wizwoz01/A2ZYNQ/docs/images/cardtest.png

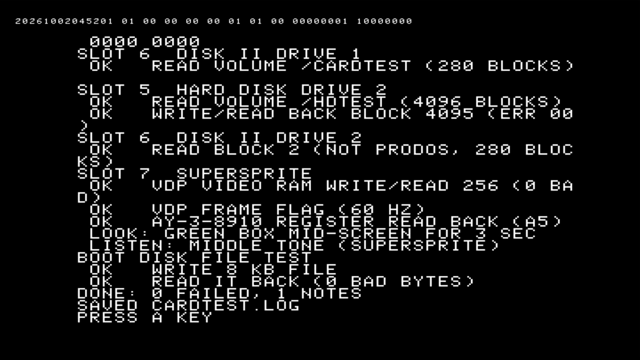
docs/images/cardtest.png
