wizwoz01/A2ZYNQ/hardware/pcb/bottom.png

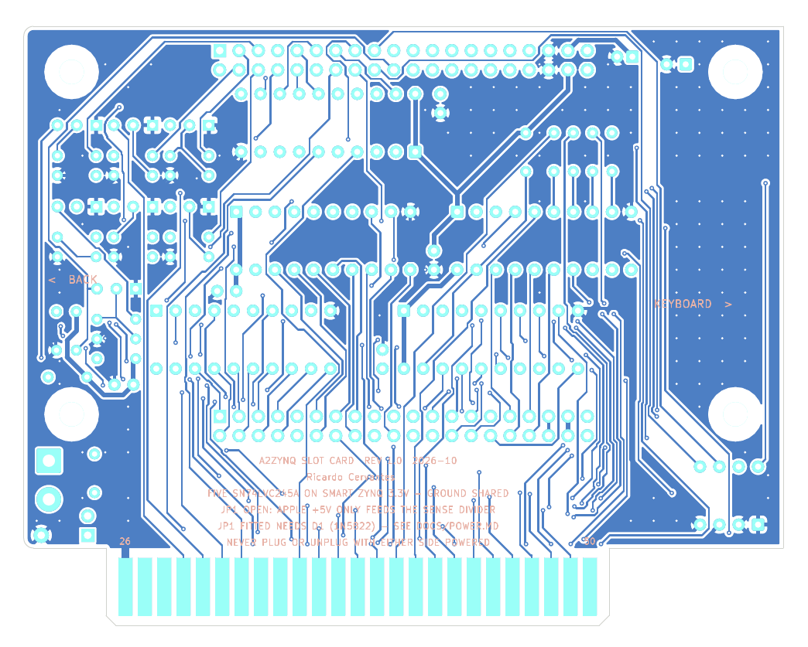
hardware/pcb/bottom.png
