wizwoz01/A2ZYNQ/hardware/schematics/red_proto_card_schematic.pdf

A | A
B | B
C | C
D | D

### A2N20v2 Red Proto Card

Block Diagram

Size: A4 | Rev: 3.0 | 1/13

from Smart Zynq style

# Red Proto Card — System Block Diagram

Apple II Slot

JAPPLE 50-pin
5V bus logic
CARD_5V / GND

Proto Card

U1–U4 SN74LVC245A
U5 TXB0108/TXS0108
Q1–Q6 OC drivers
Q7 /RES sense

Smart Zynq

JZ1 = U12 Bank33
JZ2 = U13 Bank35
VCC3V3 out
Apple nets | A2_* nets

POWER DOMAINS
CARD_5V = Apple pin 25 → U5 VCCB + 15k/22k sense only
VCC3V3 = Zynq JZ1/JZ2 pins 37–38 → U1–U4 VCC, U5 VCCA, pull-ups, Q7 pull-up GND = Apple pin 26 ↔ JGND (≥4 wires) ↔ Zynq GND
JZ 39–40 board +5V = DEFAULT NOT CONNECTED

SHEETS
2–5 U1–U4 6 U5 TXB 7–8 Q1–Q6 9 Q7+5V sense 10 JAPPLE 11 JZ1/U12 12 JZ2/U13 13 Rules / short check

# A2N20v2 / Smart Zynq Proto Adapter

# U1 SN74LVC245A

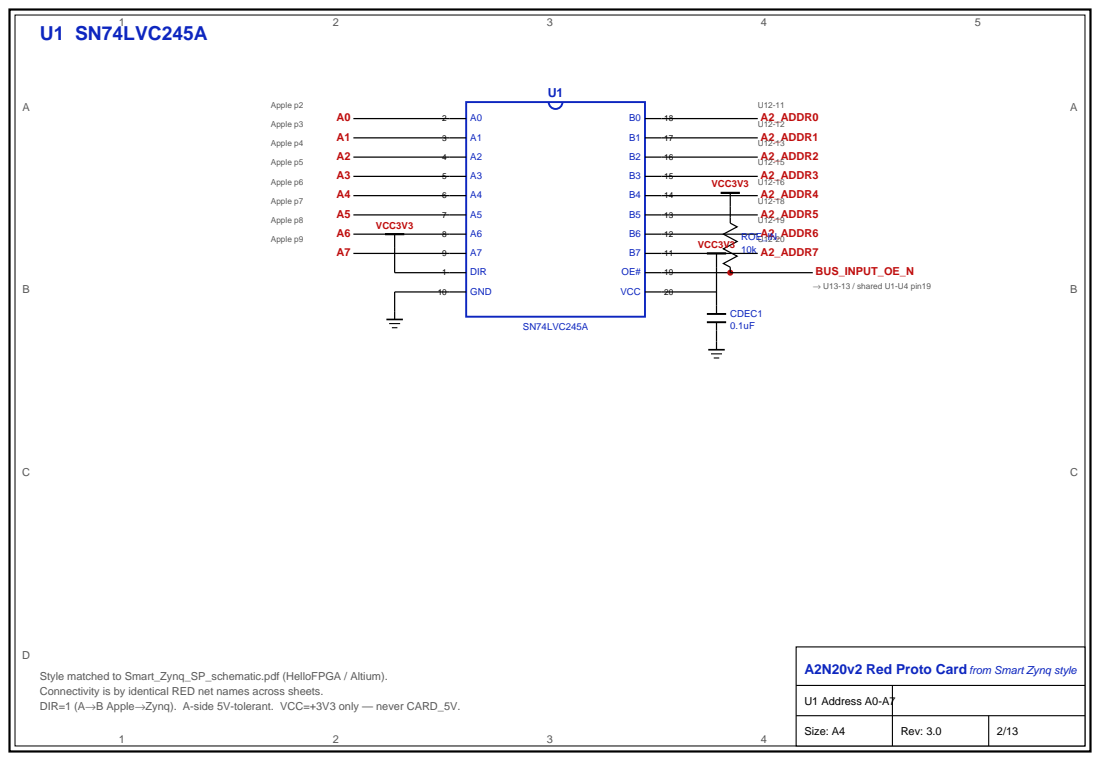
[picture p6: page 2]
U1 Address A0-A7; SN74LVC245A; DIR; GND; VCC; Apple p2; Apple p3; Apple p4; Apple p5; Apple p6; Apple p7; Apple p8; Apple p9; A2_ADDR0; A2_ADDR1; A2_ADDR2; A2_ADDR3; A2_ADDR4; A2_ADDR5; A2_ADDR6; A2_ADDR7; VCC3V3; ROE_IN 10k; BUS_INPUT_OE_N; → U13-13 / shared U1-U4 pin19; CDEC1 0.1uF

Style matched to Smart_Zynq_SP_schematic.pdf (HelloFPGA / Altium).
Connectivity is by identical RED net names across sheets.
DIR=1 (A→B Apple→Zynq). A-side 5V-tolerant. VCC=+3V3 only — never CARD_5V.

A2N20v2 Red Proto Card

from Smart Zynq style

# U2 SN74LVC245A

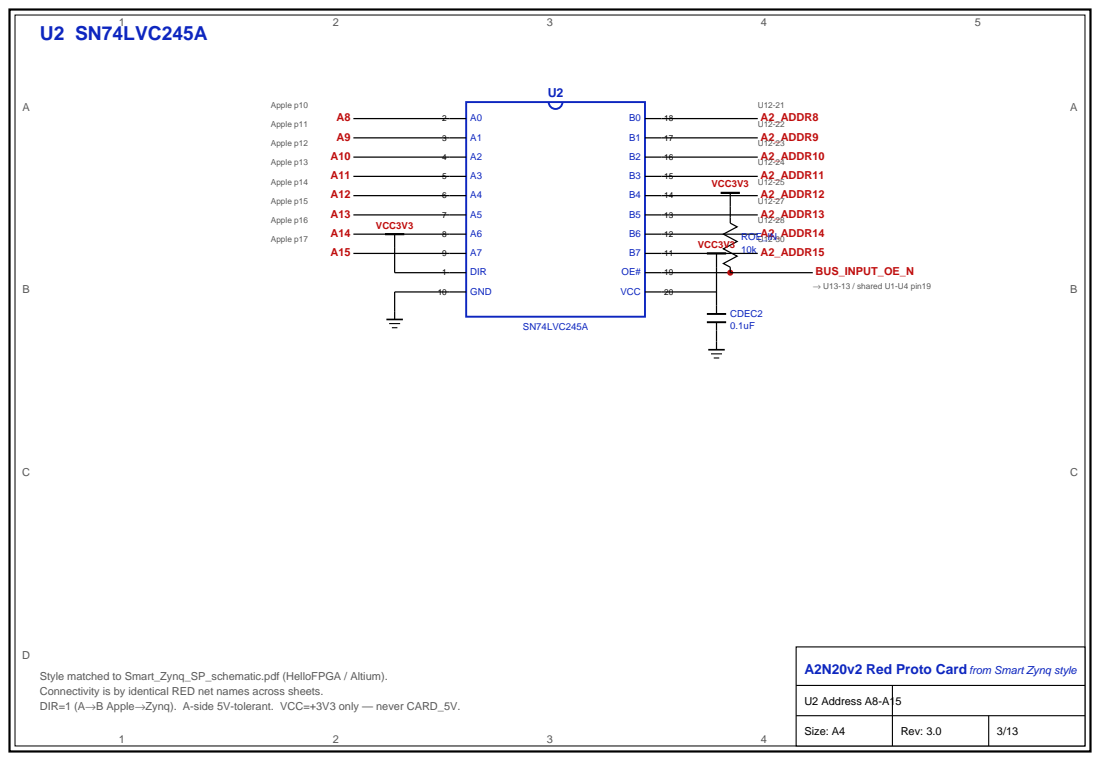
[picture p7: page 3]
U2 Address A8-A15; SN74LVC245A; DIR; GND; VCC; Apple p10; Apple p11; Apple p12; Apple p13; Apple p14; Apple p15; Apple p16; Apple p17; A2_ADDR8; A2_ADDR9; A2_ADDR10; A2_ADDR11; A2_ADDR12; A2_ADDR13; A2_ADDR14; A2_ADDR15; VCC3V3; ROE_IN 10k; BUS_INPUT_OE_N; → U13-13 / shared U1-U4 pin19; CDEC2 0.1uF

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

A2N20v2 Red Proto Card

from Smart Zynq style

# U3 SN74LVC245A

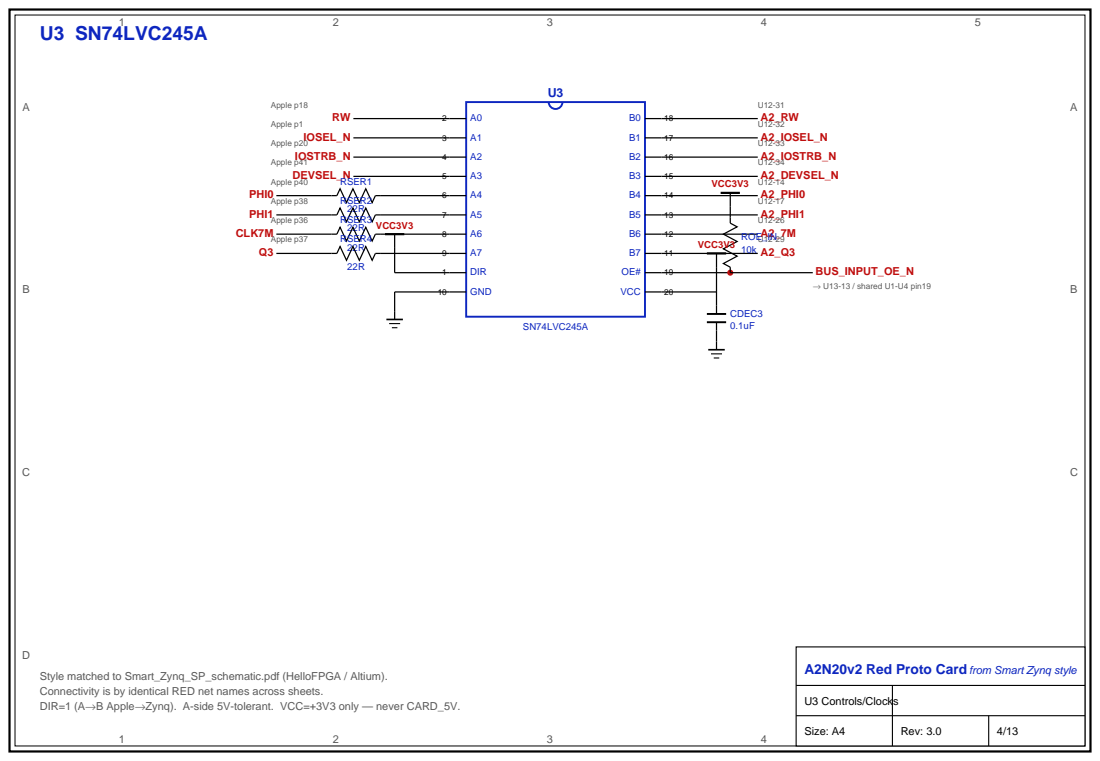
[picture p8: page 4]
U3 Controls/Clocks; SN74LVC245A; DIR; GND; VCC; Apple p18; IOSEL_N; Apple p1; IOSTRB_N; Apple p20; DEVSEL_N; Apple p41; RSER1; PHI0; Apple p40; RSER2; PHI1; Apple p38; RSER3; CLK7M; Apple p36; RSER4; Apple p37; A2_IOSEL_N; A2_IOSTRB_N; A2_DEVSEL_N; A2_PHI0; A2_PHI1; VCC3V3; ROE_IN 10k; BUS_INPUT_OE_N; → U13-13 / shared U1-U4 pin19; CDEC3 0.1uF

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

A2N20v2 Red Proto Card

from Smart Zynq style

# U4 SN74LVC245A

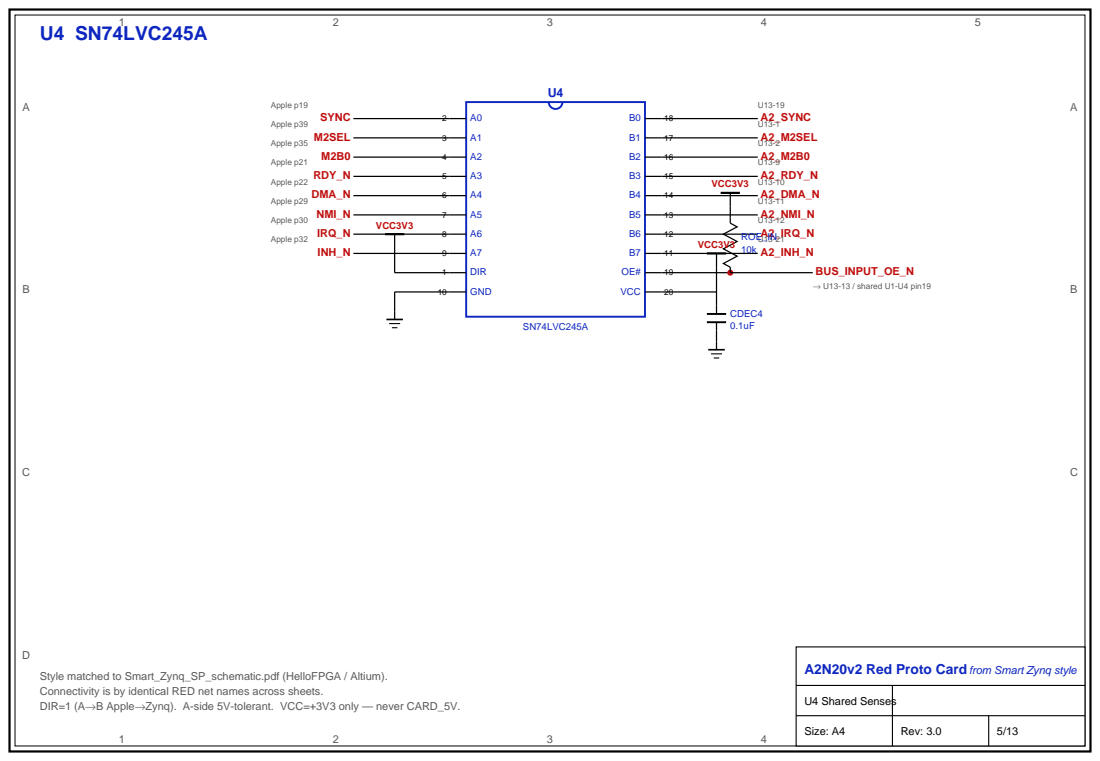
[picture p9: page 5]
U4 Shared Senses; SN74LVC245A; DIR; GND; VCC; SYNC; Apple p19; M2SEL; Apple p39; Apple p35; RDY_N; Apple p21; DMA_N; Apple p22; NMI_N; Apple p29; IRQ_N; Apple p30; INH_N; Apple p32; A2_SYNC; A2_M2SEL; A2_RDY_N; A2_DMA_N; A2_NMI_N; A2_IRQ_N; A2_INH_N; VCC3V3; ROE_IN 10k; BUS_INPUT_OE_N; → U13-13 / shared U1-U4 pin19; CDEC4 0.1uF

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

A2N20v2 Red Proto Card

from Smart Zynq style

# U5 TXB0108 / TXS0108 — D0–D7

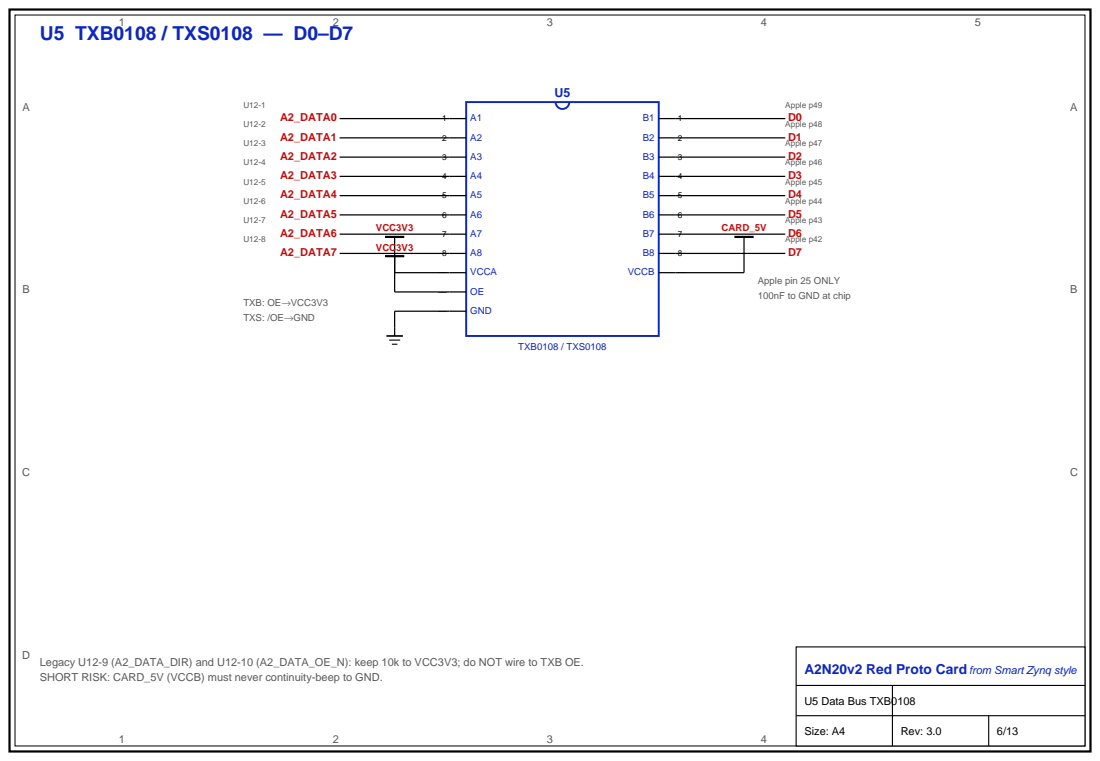
[picture p10: page 6]

Apple pin 25 ONLY
100nF to GND at chip

Legacy U12-9 (A2_DATA_DIR) and U12-10 (A2_DATA_OE_N): keep 10k to VCC3V3; do NOT wire to TXB OE.
SHORT RISK: CARD_5V (VCCB) must never continuity-beep to GND.

from Smart Zynq style

# Q1–Q3 Open Collector

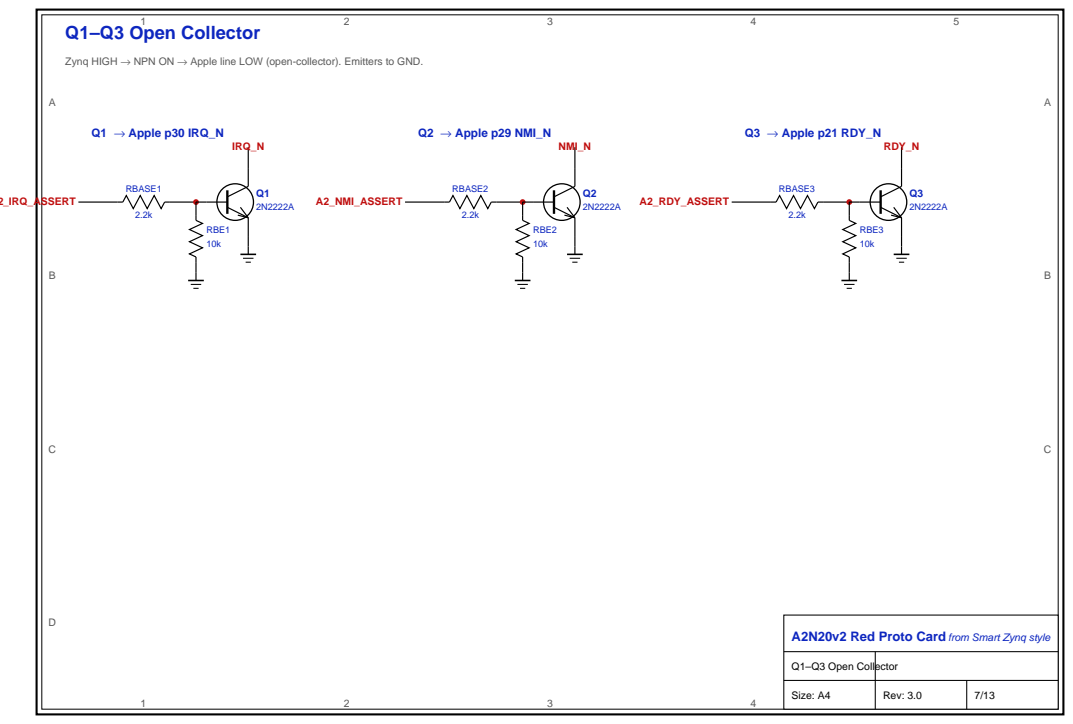
[picture p11: page 7]
Q1–Q3 Open Collector; Q1 → Apple p30 IRQ_N; A2_IRQ_ASSERT; RBASE1; RBE1 10k; IRQ_N; Q2 → Apple p29 NMI_N; A2_NMI_ASSERT; RBASE2; RBE2 10k; NMI_N; Q3 → Apple p21 RDY_N; A2_RDY_ASSERT; RBASE3; RBE3 10k; RDY_N

Zynq HIGH → NPN ON → Apple line LOW (open-collector). Emitters to GND.

A2N20v2 Red Proto Card

from Smart Zynq style

# Q4–Q6 Open Collector

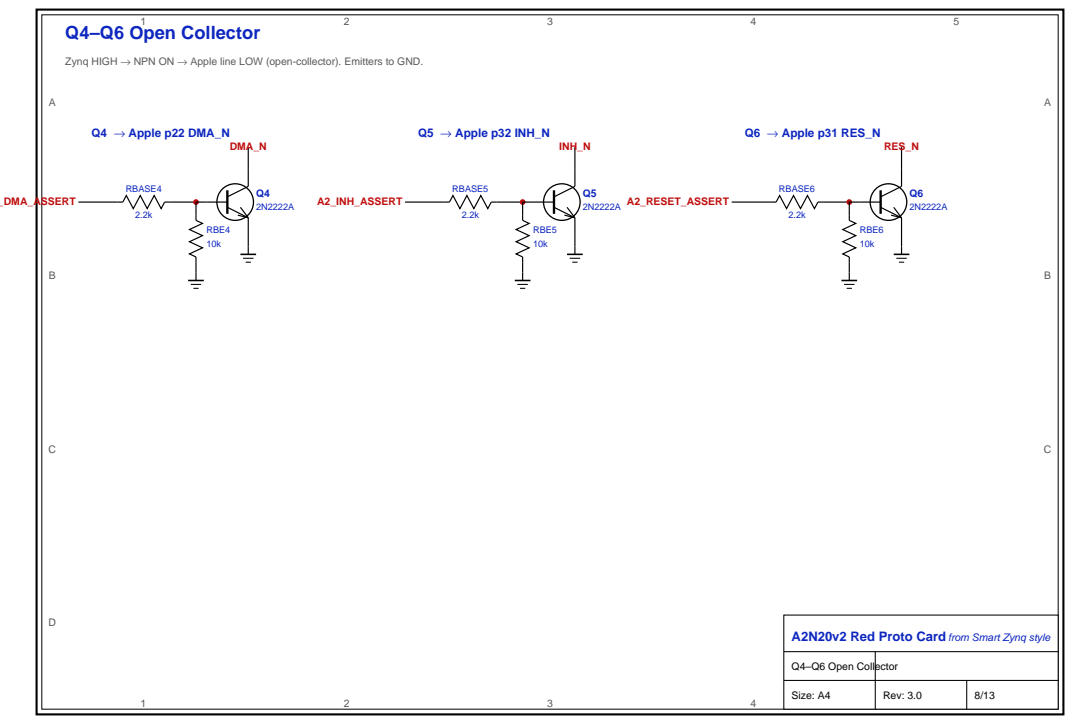
[picture p12: page 8]
Q4–Q6 Open Collector; Q4 → Apple p22 DMA_N; A2_DMA_ASSERT; RBASE4; RBE4 10k; DMA_N; Q5 → Apple p32 INH_N; A2_INH_ASSERT; RBASE5; RBE5 10k; INH_N; Q6 → Apple p31 RES_N; A2_RESET_ASSERT; RBASE6; RBE6 10k; RES_N

Zynq HIGH → NPN ON → Apple line LOW (open-collector). Emitters to GND.

A2N20v2 Red Proto Card

from Smart Zynq style

# Q7 /RES sense (inverting)

# Apple +5V presence sense

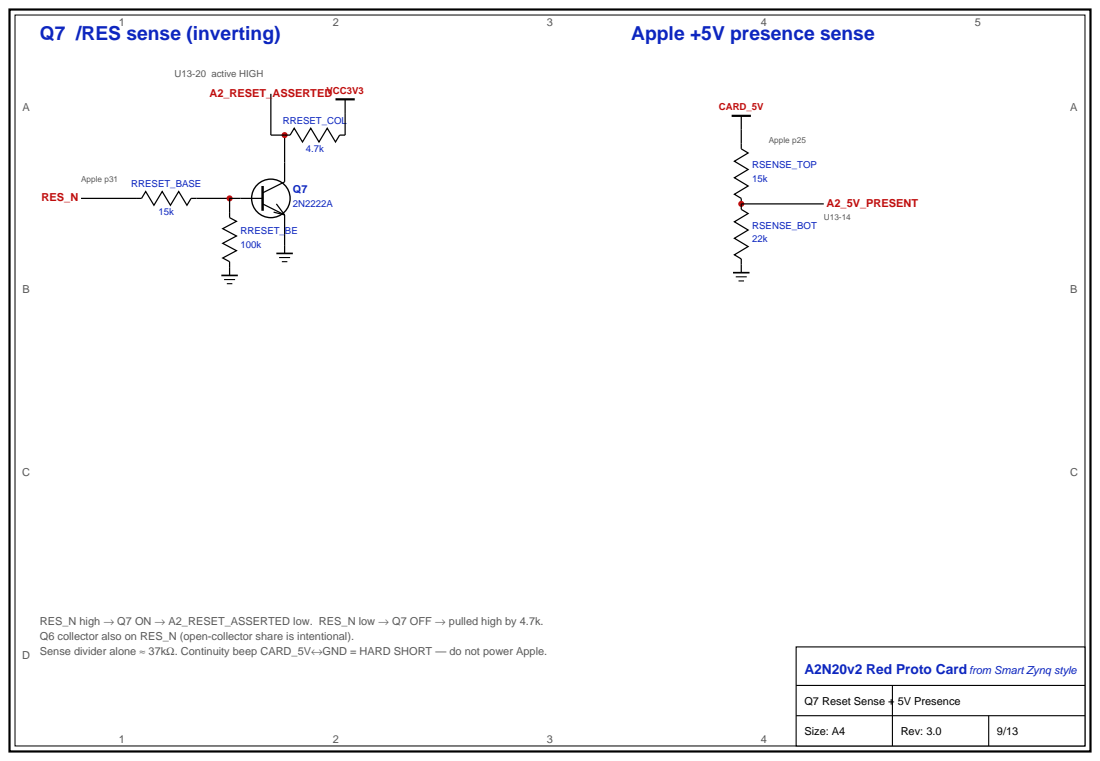
[picture p13: page 9]
RES_N; Apple p31; RRESET_BASE; RRESET_BE 100k; RRESET_COL; A2_RESET_ASSERTEDVCC3V3; U13-20 active HIGH; CARD_5V; Apple p25; RSENSE_TOP 15k; A2_5V_PRESENT; RSENSE_BOT 22k

RES_N high → Q7 ON → A2_RESET_ASSERTED low. RES_N low → Q7 OFF → pulled high by 4.7k.
Q6 collector also on RES_N (open-collector share is intentional).
Sense divider alone ≈ 37kΩ. Continuity beep CARD_5V↔GND = HARD SHORT — do not power Apple.

A2N20v2 Red Proto Card

from Smart Zynq style

Q7 Reset Sense + 5V Presence

A | A
B | B
C | C
D | D

### A2N20v2 Red Proto Card

JAPPLE

| from Smart Zynq style

# JAPPLE Apple II Edge JAPPLE

IOSEL_N | 1 | IOSEL_N
A0 | 2 | A0
A1 | 3 | A1
A2 | 4 | A2
A3 | 5 | A3
A4 | 6 | A4
A5 | 7 | A5
A6 | 8 | A6
A7 | 9 | A7
A8 | 10 | A8
A9 | 11 | A9
A10 | 12 | A10
A11 | 13 | A11
A12 | 14 | A12
A13 | 15 | A13
A14 | 16 | A14
A15 | 17 | A15
RW | 18 | RW
SYNC | 19 | SYNC
IOSTRB_N | 20 | IOSTRB_N
RDY_N | 21 | RDY_N
DMA_N | 22 | DMA_N
23 | NC
24 | NC
| 25

CARD_5V

CARD_5V

JAPPLE

GND | 26
27 | NC
28 | NC
NMI_N | 29 | NMI_N
IRQ_N | 30 | IRQ_N
RES_N | 31 | RES_N
INH_N | 32 | INH_N
33 | NC
34 | NC
M2B0 | 35 | M2B0
CLK7M | 36 | CLK7M
Q3 | 37 | Q3
PHI1 | 38 | PHI1
M2SEL | 39 | M2SEL
PHI0 | 40 | PHI0
DEVSEL_N | 41 | DEVSEL_N
D7 | 42 | D7
D6 | 43 | D6
D5 | 44 | D5
D4 | 45 | D4
D3 | 46 | D3
D2 | 47 | D2
D1 | 48 | D1
D0 | 49 | D0
50 | NC

A | A
B | B
C | C
D | D

### A2N20v2 Red Proto Card

JZ1 U12

| from Smart Zynq style

# JZ1 U12/J6

JZ1

A2_DATA0 | 1 | A2_DATA0
A2_DATA1 | 2 | A2_DATA1
A2_DATA2 | 3 | A2_DATA2
A2_DATA3 | 4 | A2_DATA3
A2_DATA4 | 5 | A2_DATA4
A2_DATA5 | 6 | A2_DATA5
A2_DATA6 | 7 | A2_DATA6
A2_DATA7 | 8 | A2_DATA7
A2_DATA_DIR | 9 | A2_DATA_DIR
A2_DATA_OE_N | 10 | A2_DATA_OE_N
A2_ADDR0 | 11 | A2_ADDR0
A2_ADDR1 | 12 | A2_ADDR1
A2_ADDR2 | 13 | A2_ADDR2
A2_PHI0 | 14 | A2_PHI0
A2_ADDR3 | 15 | A2_ADDR3
A2_ADDR4 | 16 | A2_ADDR4
A2_PHI1 | 17 | A2_PHI1
A2_ADDR5 | 18 | A2_ADDR5
A2_ADDR6 | 19 | A2_ADDR6

JZ1

A2_ADDR7 | 20 | A2_ADDR7
A2_ADDR8 | 21 | A2_ADDR8
A2_ADDR9 | 22 | A2_ADDR9
A2_ADDR10 | 23 | A2_ADDR10
A2_ADDR11 | 24 | A2_ADDR11
A2_ADDR12 | 25 | A2_ADDR12
A2_7M | 26 | A2_7M
A2_ADDR13 | 27 | A2_ADDR13
A2_ADDR14 | 28 | A2_ADDR14
A2_Q3 | 29 | A2_Q3
A2_ADDR15 | 30 | A2_ADDR15
A2_RW | 31 | A2_RW
A2_IOSEL_N | 32 | A2_IOSEL_N
A2_IOSTRB_N | 33 | A2_IOSTRB_N
A2_DEVSEL_N | 34 | A2_DEVSEL_N
VCC3V3 | 37 | VCC3V3
VCC3V3 | 38 | VCC3V3
39 | NC
40 | NC
P 1 A2_DATA0 | U5-A1
P 2 A2_DATA1 | U5-A2
P 3 A2_DATA2 | U5-A3
P 4 A2_DATA3 | U5-A4
P 5 A2_DATA4 | U5-A5
P 6 A2_DATA5 | U5-A6
P 7 A2_DATA6 | U5-A7
P 8 A2_DATA7 | U5-A8

A | A
B | B
C | C
D | D

### A2N20v2 Red Proto Card

JZ2 U13

| from Smart Zynq style

# JZ2 U13/J5

JZ2

A2_M2SEL | 1 | A2_M2SEL
A2_M2B0 | 2 | A2_M2B0
A2_IRQ_ASSERT | 3 | A2_IRQ_ASSERT
A2_NMI_ASSERT | 4 | A2_NMI_ASSERT
A2_RDY_ASSERT | 5 | A2_RDY_ASSERT
A2_DMA_ASSERT | 6 | A2_DMA_ASSERT
A2_INH_ASSERT | 7 | A2_INH_ASSERT
A2_RESET_ASSERT | 8 | A2_RESET_ASSERT
A2_RDY_N | 9 | A2_RDY_N
A2_DMA_N | 10 | A2_DMA_N
A2_NMI_N | 11 | A2_NMI_N
A2_IRQ_N | 12 | A2_IRQ_N
BUS_INPUT_OE_N | 13 | BUS_INPUT_OE_N

JZ2

A2_5V_PRESENT | 14 | A2_5V_PRESENT
SW1 | 15 | SW1
SW2 | 16 | SW2
SW3 | 17 | SW3
SW4 | 18 | SW4
A2_SYNC | 19 | A2_SYNC
A2_RESET_ASSERTED | 20 | A2_RESET_ASSERTED
A2_INH_N | 21 | A2_INH_N
PL_READY | 27 | PL_READY
VCC3V3 | 37 | VCC3V3
VCC3V3 | 38 | VCC3V3
39 | NC
40 | NC
P 1 A2_M2SEL | U4-B1
P 2 A2_M2B0 | U4-B2
P 3 A2_IRQ_ASSERT | Q1
P 4 A2_NMI_ASSERT | Q2
P 5 A2_RDY_ASSERT | Q3
P 6 A2_DMA_ASSERT | Q4
P 7 A2_INH_ASSERT | Q5
P 8 A2_RESET_ASSERT | Q6

A | A
B | B
C | C
D | D

### A2N20v2 Red Proto Card

Rules / Short Checklist

| from Smart Zynq style

# Assembly rules & 5V short checklist

REQUIRED PARTS (manual BOM — often missed on first build)
ROE_IN 10k on BUS_INPUT_OE_N; ROE_DATA 10k on U12-10; RDIR_DATA 10k on U12-9 RSENSE_BOT 22k; CDEC 0.1uF on each LVC245; 0.1uF on TXB VCCA and VCCB

NC APPLE PINS: 23, 24, 27, 28, 33, 34, 50
JZ1/JZ2 pins 39–40 (+5V board) DEFAULT NC

TXB0108 OE = active HIGH → VCC3V3 TXS0108 /OE = active LOW → GND

5V ↔ GND SHORT (power OFF)
1. Card alone, ribbons off: meter Apple finger 25 to 26 — must NOT beep
2. If beep: bridge 25/26, TXB VCCB wiring, or dead U5 — lift VCCB and retest
3. If open alone but shorts with ribbons: disconnect JZ 39/40 and any 5V feed
4. Sense path alone is ~37kΩ (never a continuity beep)

Netlist sources: hardware/*.csv + docs/A2N20v2_Smart_Zynq_FINAL_Manual.pdf Visual style reference: references/Smart_Zynq_SP_schematic.pdf
