wizwoz01/A2ZYNQ/hardware/pcb/assembly.pdf

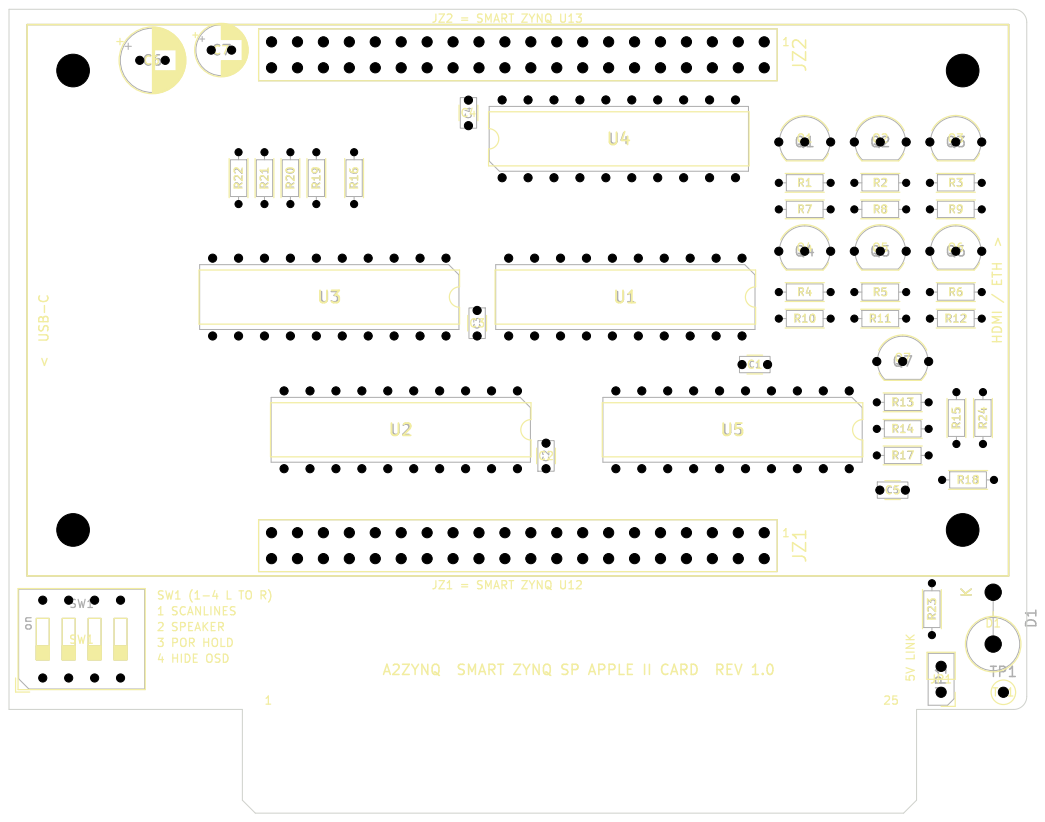
[picture p14: page 1]

< USB-C HDMI / ETH > A2ZYNQ SMART ZYNQ SP APPLE II CARD REV 1.0 JP1 C5 Q5 R11 Q2 U5
