wizwoz01/A2ZYNQ/hardware/pcb/a2zynq_card.kicad_pcb

## KiCad design hardware/pcb/a2zynq_card.kicad_pcb (2026-10-05)

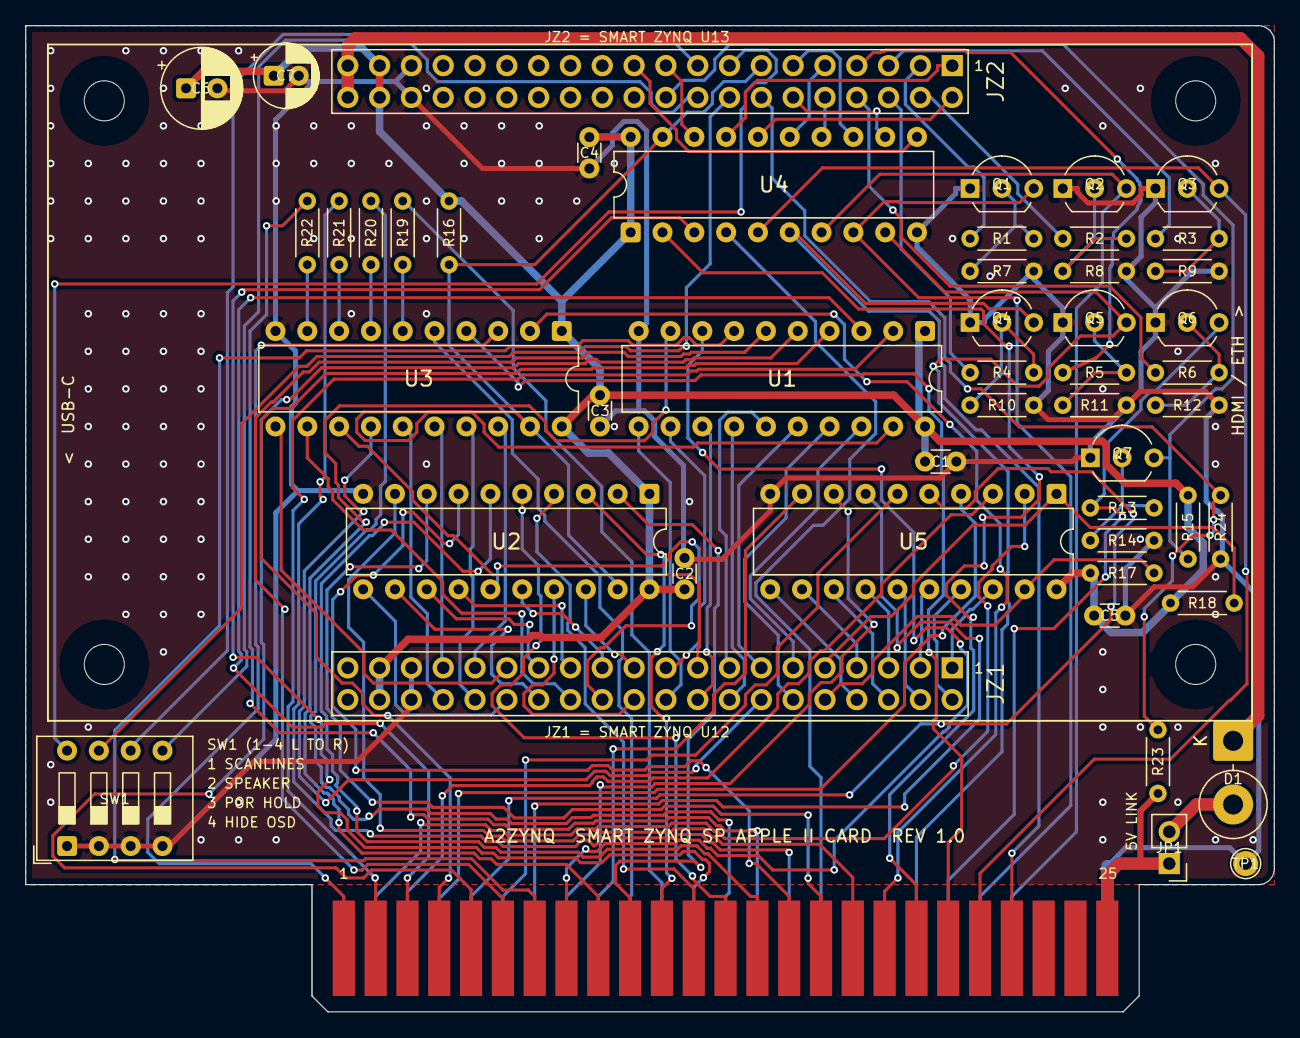
[picture p15: board a2zynq_card.kicad_pcb from above]

Board: 2 copper layers, 99.7 x 78.7 mm, 54 parts (0 on the bottom side), 112 nets.

Parts:
C1, C2, C3, C4, C5: 100n; C_Disc_D3.0mm_W1.6mm_P2.50mm
C6: 100u; CP_Radial_D6.3mm_P2.50mm
C7: 10u; CP_Radial_D5.0mm_P2.00mm
D1: 1N5822 (option); D_DO-201AD_P5.08mm_Vertical_KathodeUp
J1: Apple II slot; Apple_II_Slot_Edge
JP1: 5V LINK (open); PinHeader_1x02_P2.54mm_Vertical
JZ1: Smart Zynq U12 (bank 33); SmartZynq_2x20_U12
JZ2: Smart Zynq U13 (bank 35); SmartZynq_2x20_U13
MH1, MH2, MH3, MH4: M3; MountingHole_3.2mm_M3
Q1, Q2, Q3, Q4, Q5, Q6, Q7: 2N3904; TO-92_Inline_Wide
R1, R2, R3, R4, R5, R6: 2.2k; R_Axial_DIN0204_L3.6mm_D1.6mm_P5.08mm_Horizontal
R7, R8, R9, R10, R11, R12, R16, R17, R18: 10k; R_Axial_DIN0204_L3.6mm_D1.6mm_P5.08mm_Horizontal
R13, R23: 15k; R_Axial_DIN0204_L3.6mm_D1.6mm_P5.08mm_Horizontal
R14: 100k; R_Axial_DIN0204_L3.6mm_D1.6mm_P5.08mm_Horizontal
R15: 4.7k; R_Axial_DIN0204_L3.6mm_D1.6mm_P5.08mm_Horizontal
R19, R20, R21, R22: 33R; R_Axial_DIN0204_L3.6mm_D1.6mm_P5.08mm_Horizontal
R24: 22k; R_Axial_DIN0204_L3.6mm_D1.6mm_P5.08mm_Horizontal
SW1: DIP x4; SW_DIP_SPSTx04_Slide_9.78x12.34mm_W7.62mm_P2.54mm
TP1: GND; TestPoint_THTPad_D2.0mm_Drill1.0mm
U1, U2, U3, U4, U5: SN74LVC245AN; DIP-20_W7.62mm

Connections:
5V_LINK: D1.2, JP1.2
A0: J1.2, U1.2
A1: J1.3, U1.3
A2: J1.4, U1.4
A2_5V_PRESENT: JZ2.14, R23.2, R24.1
A2_7M: JZ1.26, U3.12
A2_ADDR0: JZ1.11, U1.18
A2_ADDR1: JZ1.12, U1.17
A2_ADDR2: JZ1.13, U1.16
A2_ADDR3: JZ1.15, U1.15
A2_ADDR4: JZ1.16, U1.14
A2_ADDR5: JZ1.18, U1.13
A2_ADDR6: JZ1.19, U1.12
A2_ADDR7: JZ1.20, U1.11
A2_ADDR8: JZ1.21, U2.18
A2_ADDR9: JZ1.22, U2.17
A2_ADDR10: JZ1.23, U2.16
A2_ADDR11: JZ1.24, U2.15
A2_ADDR12: JZ1.25, U2.14
A2_ADDR13: JZ1.27, U2.13
A2_ADDR14: JZ1.28, U2.12
A2_ADDR15: JZ1.30, U2.11
A2_DATA0: JZ1.1, U5.18
A2_DATA1: JZ1.2, U5.17
A2_DATA2: JZ1.3, U5.16
A2_DATA3: JZ1.4, U5.15
A2_DATA4: JZ1.5, U5.14
A2_DATA5: JZ1.6, U5.13
A2_DATA6: JZ1.7, U5.12
A2_DATA7: JZ1.8, U5.11
A2_DATA_DIR: JZ1.9, R18.2, U5.1
A2_DATA_OE_N: JZ1.10, R17.2, U5.19
A2_DEVSEL_N: JZ1.34, U3.15
A2_DMA_ASSERT: JZ2.6, R4.1
A2_DMA_N_SENSE: JZ2.10, U4.14
A2_INH_ASSERT: JZ2.7, R5.1
A2_INH_N_SENSE: JZ2.21, U4.11
A2_IOSEL_N: JZ1.32, U3.17
A2_IOSTRB_N: JZ1.33, U3.16
A2_IRQ_ASSERT: JZ2.3, R1.1
A2_IRQ_N_SENSE: JZ2.12, U4.12
A2_M2B0: JZ2.2, U4.16
A2_M2SEL: JZ2.1, U4.17
A2_NMI_ASSERT: JZ2.4, R2.1
A2_NMI_N_SENSE: JZ2.11, U4.13
A2_PHI0: JZ1.14, U3.14
A2_PHI1: JZ1.17, U3.13
A2_Q3: JZ1.29, U3.11
A2_RDY_ASSERT: JZ2.5, R3.1
A2_RDY_N_SENSE: JZ2.9, U4.15
A2_RESET_ASSERT: JZ2.8, R6.1
A2_RESET_ASSERTED_SENSE: JZ2.20, Q7.3, R15.2
A2_RW: JZ1.31, U3.18
A2_SYNC: JZ2.19, U4.18
A3: J1.5, U1.5
A4: J1.6, U1.6
A5: J1.7, U1.7
A6: J1.8, U1.8
A7: J1.9, U1.9
A8: J1.10, U2.2
A9: J1.11, U2.3
A10: J1.12, U2.4
A11: J1.13, U2.5
A12: J1.14, U2.6
A13: J1.15, U2.7
A14: J1.16, U2.8
A15: J1.17, U2.9
BUS_INPUT_OE_N: JZ2.13, R16.2, U1.19, U2.19, U3.19, U4.19
CARD_5V: J1.25, JP1.1, R23.1
CLK7M: J1.36, R21.1
CLK7M_R: R21.2, U3.8
D0: J1.49, U5.2
D1: J1.48, U5.3
D2: J1.47, U5.4
D3: J1.46, U5.5
D4: J1.45, U5.6
D5: J1.44, U5.7
D6: J1.43, U5.8
D7: J1.42, U5.9
DEVSEL_N: J1.41, U3.5
DIP_SW1: JZ2.15, SW1.8
DIP_SW2: JZ2.16, SW1.7
DIP_SW3: JZ2.17, SW1.6
DIP_SW4: JZ2.18, SW1.5
DMA_N: J1.22, Q4.3, U4.6
GND: C1.2, C2.2, C3.2, C4.2, C5.2, C6.2, C7.2, J1.26, JZ1.35, JZ1.36, JZ2.35, JZ2.36, Q1.1, Q2.1, Q3.1, Q4.1, Q5.1, Q6.1, Q7.1, R7.2, R8.2, R9.2, R10.2, R11.2, R12.2, R14.2, R24.2, SW1.1, SW1.2, SW1.3, SW1.4, TP1.1, U1.10, U2.10, U3.10, U4.10, U5.10
INH_N: J1.32, Q5.3, U4.9
IOSEL_N: J1.1, U3.3
IOSTRB_N: J1.20, U3.4
IRQ_N: J1.30, Q1.3, U4.8
M2B0: J1.35, U4.4
M2SEL: J1.39, U4.3
NMI_N: J1.29, Q2.3, U4.7
PHI0: J1.40, R19.1
PHI0_R: R19.2, U3.6
PHI1: J1.38, R20.1
PHI1_R: R20.2, U3.7
Q1_BASE: Q1.2, R1.2, R7.1
Q2_BASE: Q2.2, R2.2, R8.1
Q3: J1.37, R22.1
Q3_BASE: Q3.2, R3.2, R9.1
Q3_R: R22.2, U3.9
Q4_BASE: Q4.2, R4.2, R10.1
Q5_BASE: Q5.2, R5.2, R11.1
Q6_BASE: Q6.2, R6.2, R12.1
Q7_BASE: Q7.2, R13.2, R14.1
RDY_N: J1.21, Q3.3, U4.5
RES_N: J1.31, Q6.3, R13.1
RW: J1.18, U3.2
SYNC: J1.19, U4.2
VCC3V3: C1.1, C2.1, C3.1, C4.1, C5.1, C6.1, C7.1, JZ1.37, JZ1.38, JZ2.37, JZ2.38, R15.1, R16.1, R17.1, R18.1, U1.1, U1.20, U2.1, U2.20, U3.1, U3.20, U4.1, U4.20, U5.20
ZYNQ_5V: D1.1, JZ2.39, JZ2.40
