wizwoz01/A2ZYNQ/hdl/disk/apple_disk.sv

// WORK IN PROGRESS
//
// Apple II Disk II controller
//
// Adapted from:
// https://github.com/alanswx/Apple-II-Verilog_MiSTer/blob/master/rtl/disk_ii.v
// https://github.com/MiSTer-devel/Apple-II_MiSTer/blob/master/rtl/disk_ii.vhd
//
// Adapted for use with A2FPGA multicard bus interface
//
// Uses A2FPGA SDRAM controller for disk storage and requires the use
// of the PicoSoC core to provide the FAT32 file system interface
//
// Current status: Functional with hardcoded disk images
//

module DiskII #(
    parameter bit [7:0] ID = 4,
    parameter bit ENABLE = 1'b1
) (
    a2bus_if.slave a2bus_if,
    slot_if.card slot_if,

    output [7:0] data_o,
    output rd_en_o,

    mem_port_if.client ram_disk_if,

    drive_volume_if.drive volumes[2],

    input host_nib_we_i,
    input host_nib_drive_i,
    input [12:0] host_nib_addr_i,
    input [7:0] host_nib_data_i,

    // Track read-back for saves (SPI memory SPACE 6): drive, byte; data one clock later
    input host_nib_rdrive_i,
    input [12:0] host_nib_raddr_i,
    output [7:0] host_nib_rdata_o,

    // Boot menu RAM, host side (SPI memory SPACE 4, see diskmenu.a65)
    input menu_host_wr_i,
    input [10:0] menu_host_addr_i,
    input [7:0] menu_host_wdata_i,
    output [7:0] menu_host_rdata_o

);

    reg card_enable;

    always @(posedge a2bus_if.clk_logic) begin
        if (!a2bus_if.system_reset_n) begin
            card_enable <= 1'b0;
        end else if (!slot_if.config_select_n) begin
            if (slot_if.slot == 3'd0) begin  // disable all cards when slot 0 is selected for configuration
                card_enable <= 1'b0;
            end else if (slot_if.card_id == ID) begin // enable this card
                card_enable <= slot_if.card_enable && ENABLE;
            end
        end
    end

    wire card_sel = card_enable && (slot_if.card_id == ID) && a2bus_if.phi0;
    wire card_dev_sel = card_sel && !slot_if.dev_select_n;
    wire card_io_sel = card_sel && !slot_if.io_select_n;

    reg [3:0] motor_phase_r;
    reg drive_on_r;
    reg drive_real_on_r;
    reg drive2_select_r;
    reg q6_r;
    reg q7_r;

    wire [7:0] rom_dout_w;
    wire [7:0] d_out1_w;
    wire [7:0] d_out2_w;

    wire read_disk_w;
    wire write_reg_w;
    wire [7:0] data_reg_w;
    wire write_mode_w;


    always @(posedge a2bus_if.clk_logic) begin : interpret_io
        begin
            if (!a2bus_if.system_reset_n) begin
                motor_phase_r <= {4{1'b0}};
                drive_on_r <= 1'b0;
                drive2_select_r <= 1'b0;
                q6_r <= 1'b0;
                q7_r <= 1'b0;
            end else if (card_dev_sel) begin
                if (a2bus_if.addr[3] == 1'b0)
                    motor_phase_r[(a2bus_if.addr[2:1])] <= a2bus_if.addr[0];
                else
                    case (a2bus_if.addr[2:1])
                        2'b00:   drive_on_r <= a2bus_if.addr[0];
                        // A0 is trustworthy again now that apple_bus commits the
                        // address before PHI0 selects open (it was read from the
                        // previous cycle, which is why drive 2 / Q6H looked set).
                        2'b01:   drive2_select_r <= a2bus_if.addr[0];
                        2'b10:   q6_r <= a2bus_if.addr[0];
                        2'b11:   q7_r <= a2bus_if.addr[0];
                        default: ;
                    endcase
            end
        end
    end

    always @(posedge a2bus_if.clk_logic or negedge a2bus_if.system_reset_n) begin : drive_on_delay
        static reg [23:0] spindown_delay_r;
        static reg drive_on_old_r;
        if (!a2bus_if.system_reset_n) begin
            spindown_delay_r = {24{1'b0}};
            drive_real_on_r <= 1'b0;
        end else begin
            if (spindown_delay_r != 0) begin
                spindown_delay_r = 24'(spindown_delay_r - 1'b1);
                if (spindown_delay_r == 0) drive_real_on_r <= 1'b0;
            end

            if (drive_on_r == 1'b1) begin
                spindown_delay_r = {24{1'b0}};
                drive_real_on_r <= 1'b1;
            end else if (drive_on_old_r == 1'b1) spindown_delay_r = 14000000;

            drive_on_old_r = drive_on_r;
        end
    end

    wire drive_1_active = drive_real_on_r & (~drive2_select_r);
    wire drive_2_active = drive_real_on_r & drive2_select_r;
    assign write_mode_w = q7_r;

    assign read_disk_w = (card_dev_sel & a2bus_if.addr[3:0] == 4'hc) ? 1'b1 : 1'b0;
    assign write_reg_w = (card_dev_sel & a2bus_if.addr[3:2] == 2'b11 & a2bus_if.addr[0] == 1'b1) ? 1'b1 : 1'b0;
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
