wizwoz01/A2ZYNQ/(commit log)

2026-10-05 A2ZYNQ: the A2FPGA Multicard core on a Smart Zynq SP
    Port of the A2FPGA Multicard core to the Smart Zynq SP (Zynq-7020), with
    a2hostd on the ARM side for disk images, networking and the boot menu,
    the red proto card wiring and the rev 1.0 slot card PCB.
    [BOM.csv, a2zynq_card.kicad_pcb, a2zynq_card_bom.csv, apple_slot_pinout.csv, discrete_input_netlist.csv, open_collector_netlist.csv, smart_zynq_u12_u13_pinmap.csv, transceiver_netlist.csv]
2026-10-12 Add work-in-progress section: rev 1.0 PCB status and roadmap
    The PCB boards are ordered but not built yet. List what's done on the
    card, what's left before rev 1.0 counts as working, and the other
    planned features (power from the Apple, SSC bridge test, other
    machines, prebuilt release, web page, .woz, network lockdown).
2026-10-12 README: add HDMI captures of the menu, a game boot and the card test
    Two GIFs at double speed from the board on my IIe: the disk menu with
    the card moved through slots 1-7, and booting The Oregon Trail from the
    menu. The card test is a short video with sound (720p mp4) so the
    Mockingboard and SuperSprite tones can be heard, linked from a still of
    its 0 FAILED screen.
